derekfountain/zx-spectrum-coprocessor/test/logic_analyser_captures/dma_corruption/PXL_20250410_131411204.jpg

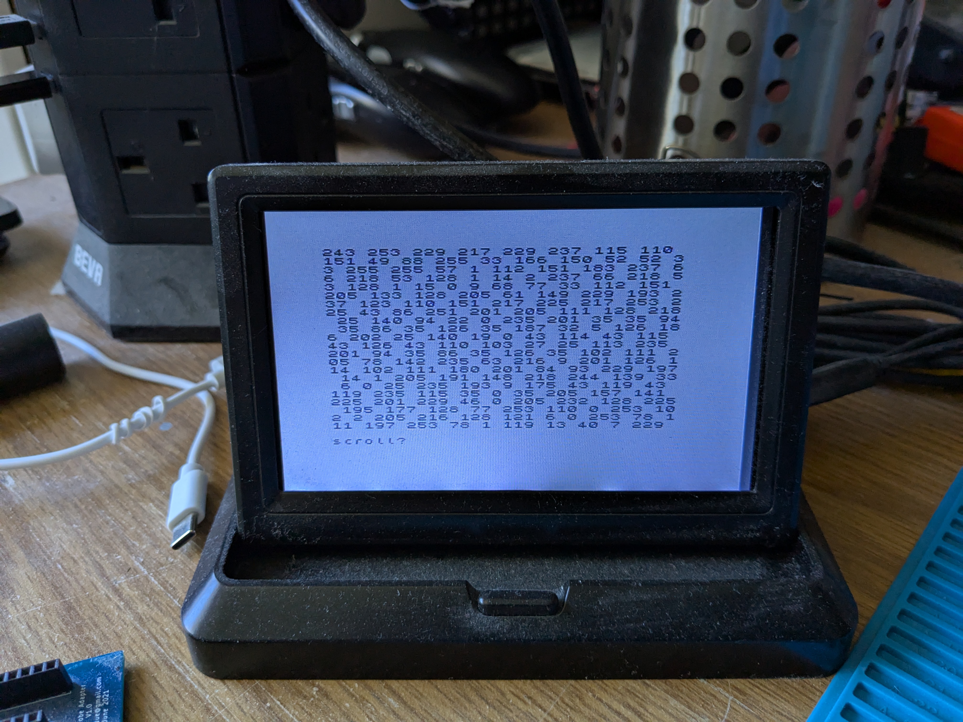
test/logic_analyser_captures/dma_corruption/PXL_20250410_131411204.jpg
