derekfountain/zx-spectrum-coprocessor/README.md

# zx-spectrum-coprocessor
Adding a modern microcontroller to a ZX Spectrum as a coprocessor
