derekfountain/zx-spectrum-coprocessor/test/spectrum/memset/contended_trace1.png

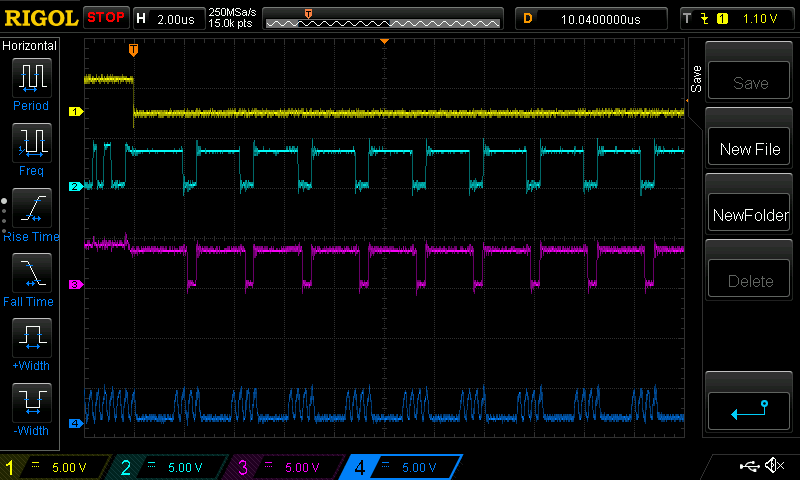
test/spectrum/memset/contended_trace1.png
