derekfountain/zx-spectrum-coprocessor/test/spectrum/memset/contended_trace2.png

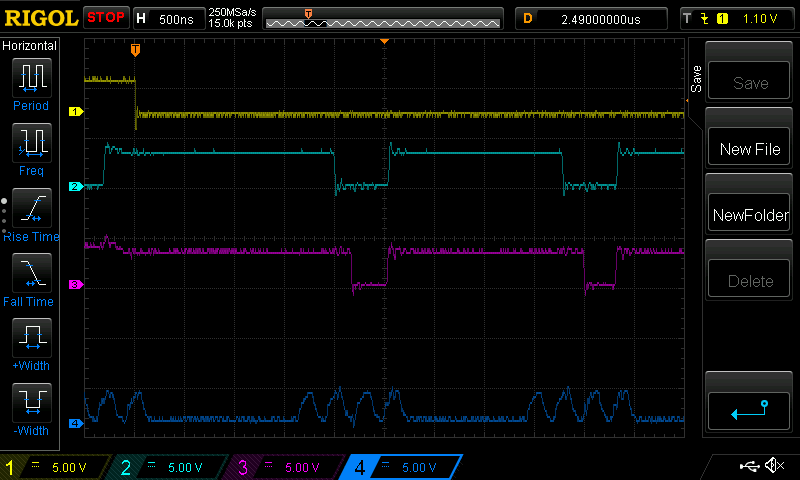
test/spectrum/memset/contended_trace2.png
