derekfountain/zx-spectrum-coprocessor/test/logic_analyser_captures/dma_corruption/LA_screenshot.png

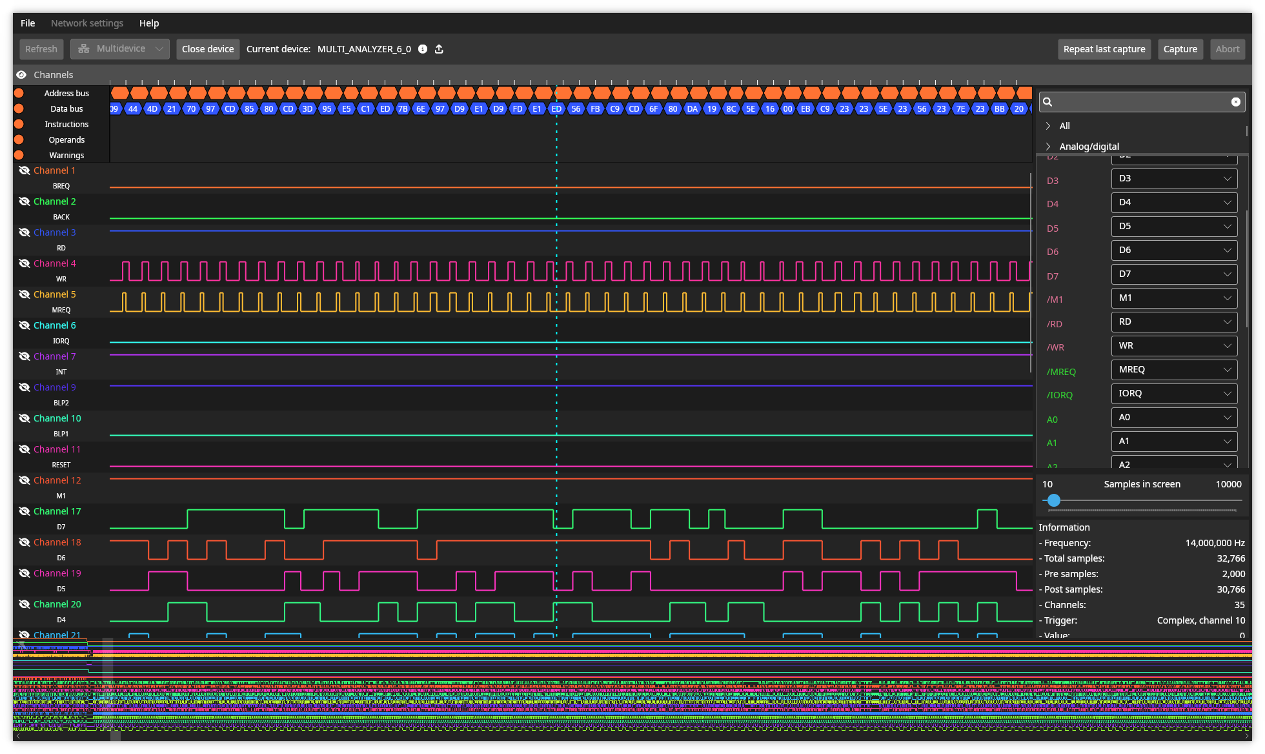
test/logic_analyser_captures/dma_corruption/LA_screenshot.png
