derekfountain/zx-spectrum-coprocessor/test/logic_analyser_captures/no_alarm_2byte_dma/no_glitch_2byte_dma_bit_instr.png

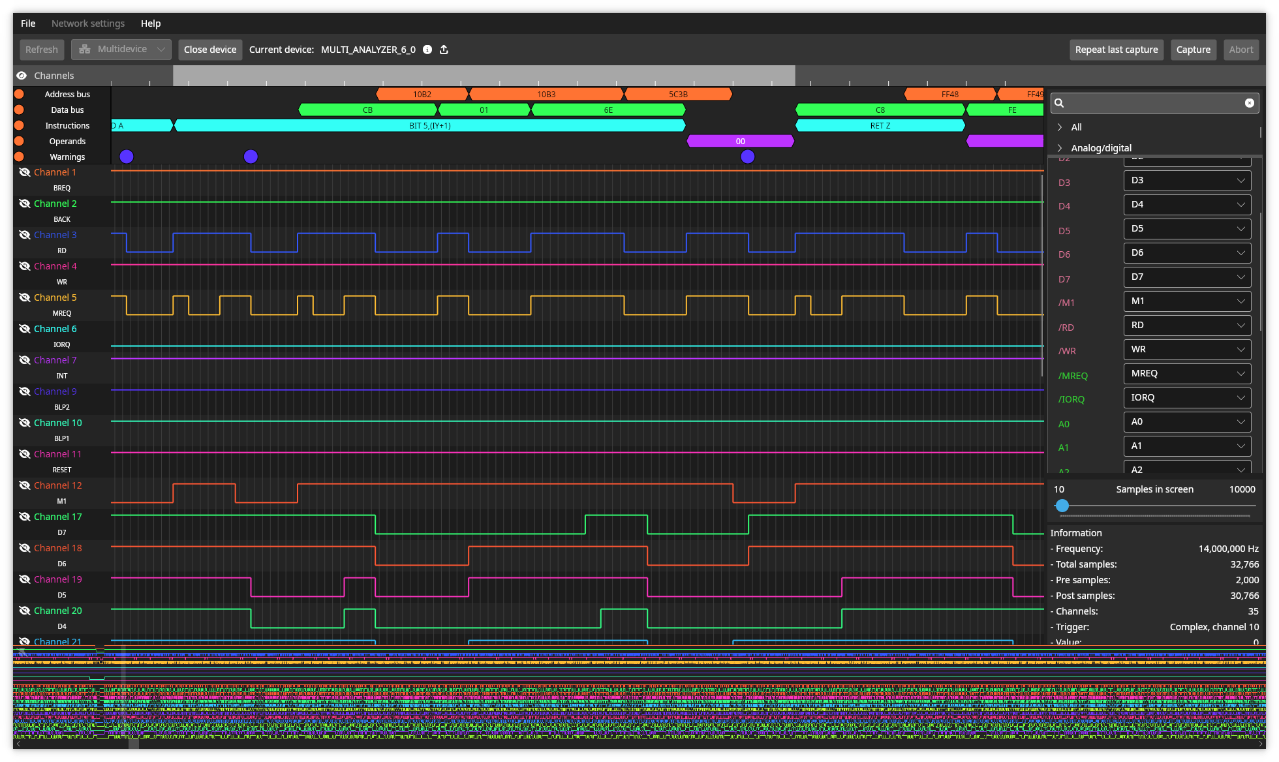
test/logic_analyser_captures/no_alarm_2byte_dma/no_glitch_2byte_dma_bit_instr.png
