derekfountain/zx-spectrum-coprocessor/test/logic_analyser_captures/zx_glitch_2byte_dma/zx_glitch_2byte_dma.png

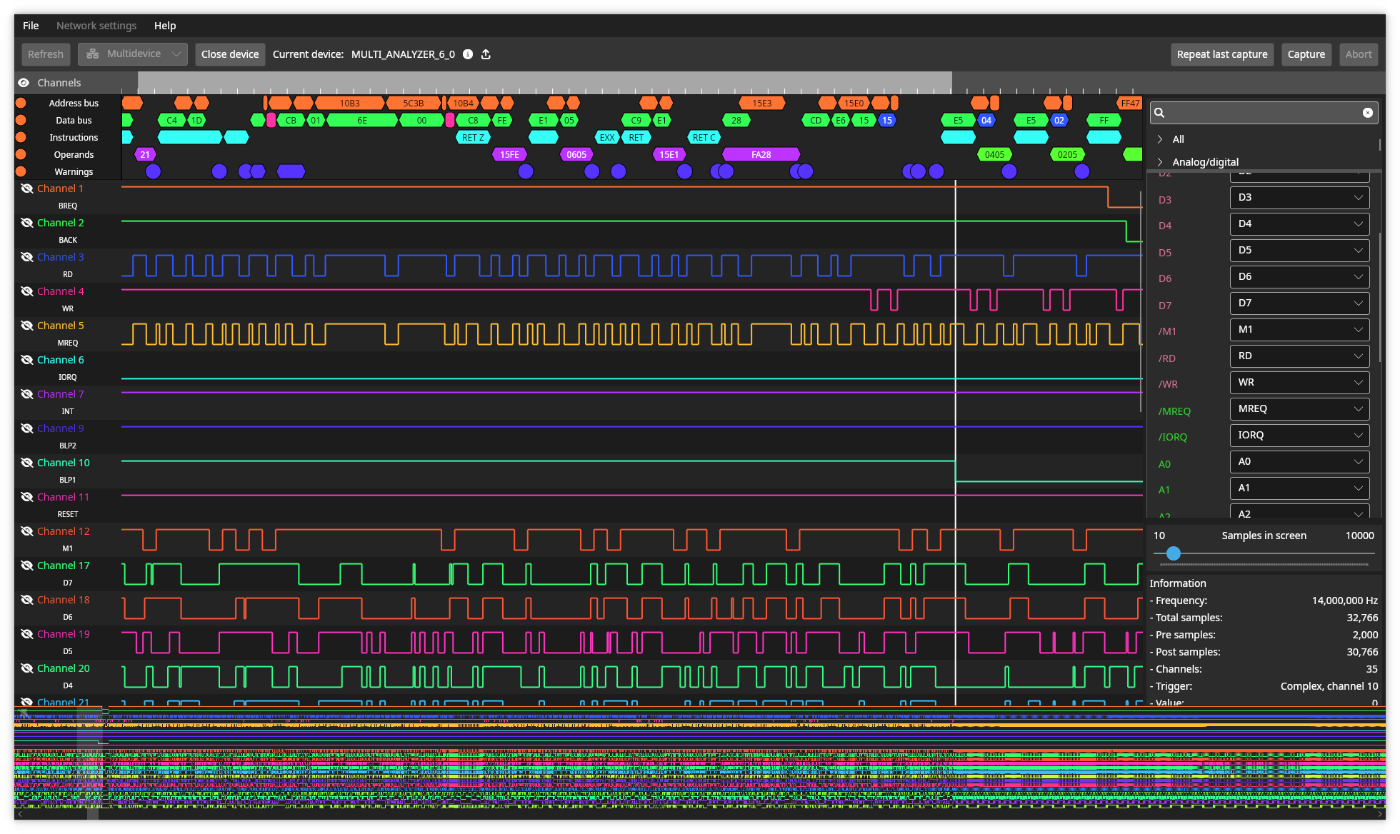
test/logic_analyser_captures/zx_glitch_2byte_dma/zx_glitch_2byte_dma.png
