derekfountain/zx-spectrum-coprocessor/test/logic_analyser_captures/zx_glitch_2byte_dma/zx_glitch_2byte_dma_bad_bit_instr.png

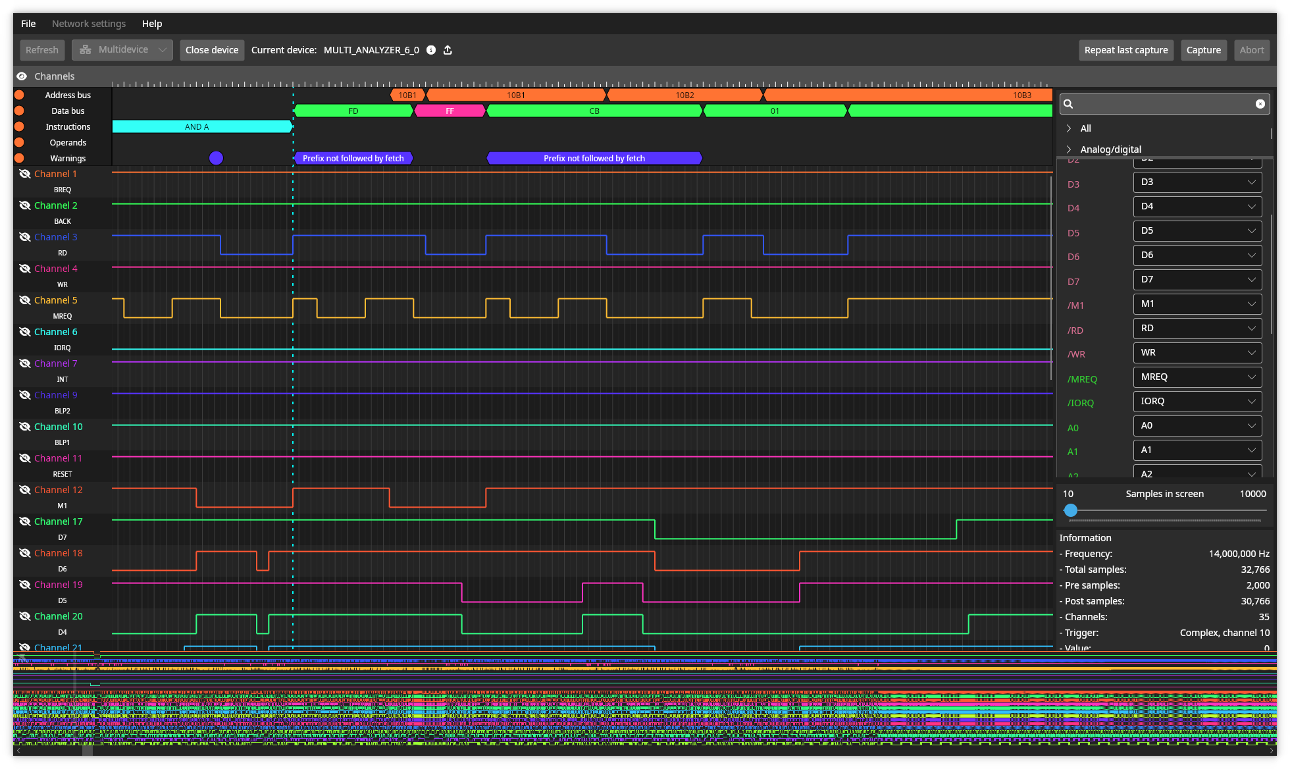
test/logic_analyser_captures/zx_glitch_2byte_dma/zx_glitch_2byte_dma_bad_bit_instr.png
