derekfountain/zx-spectrum-coprocessor/test/logic_analyser_captures/contended_failure/LA_failure_cap.png

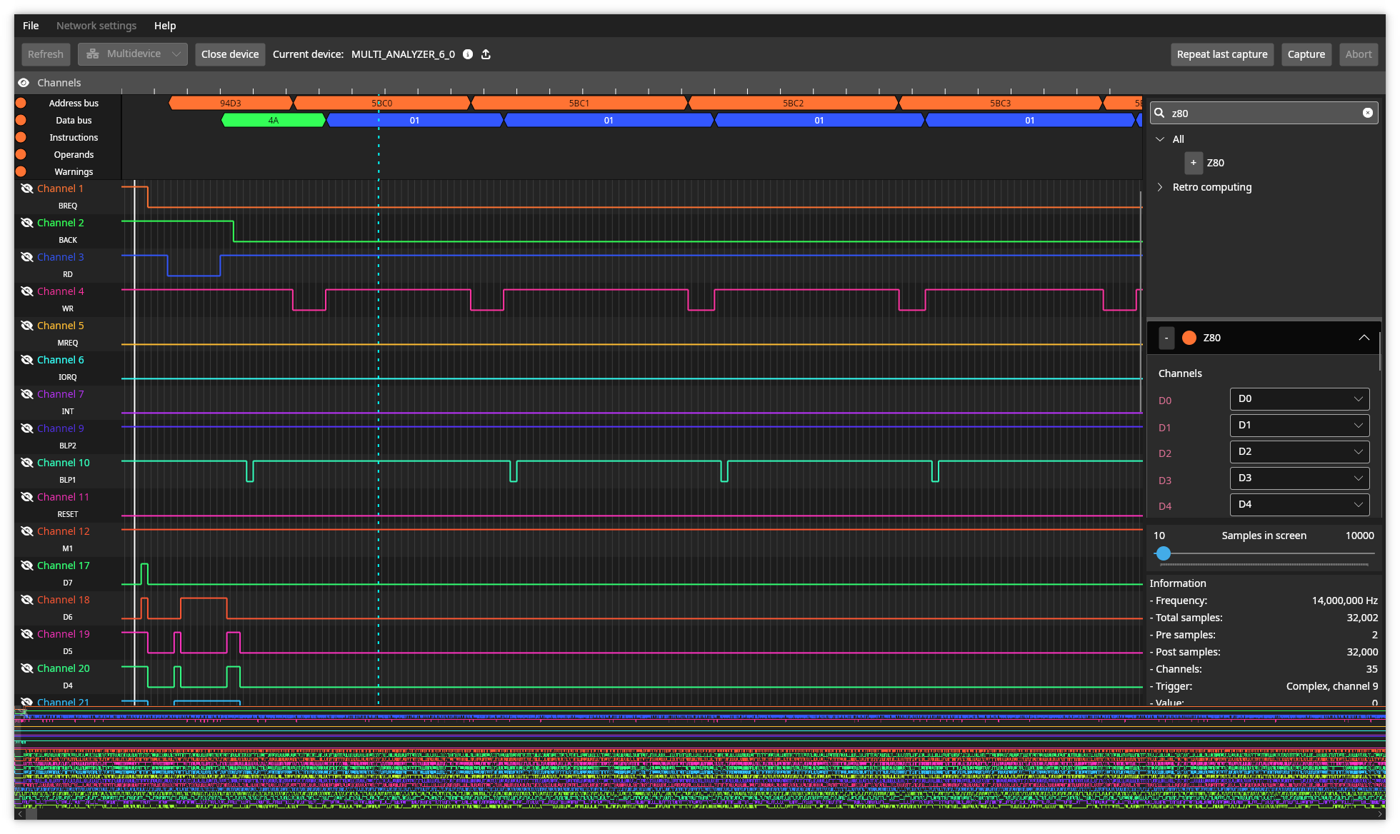
test/logic_analyser_captures/contended_failure/LA_failure_cap.png
