derekfountain/zx-spectrum-coprocessor/test/logic_analyser_captures/contended_failure/successful_1.png

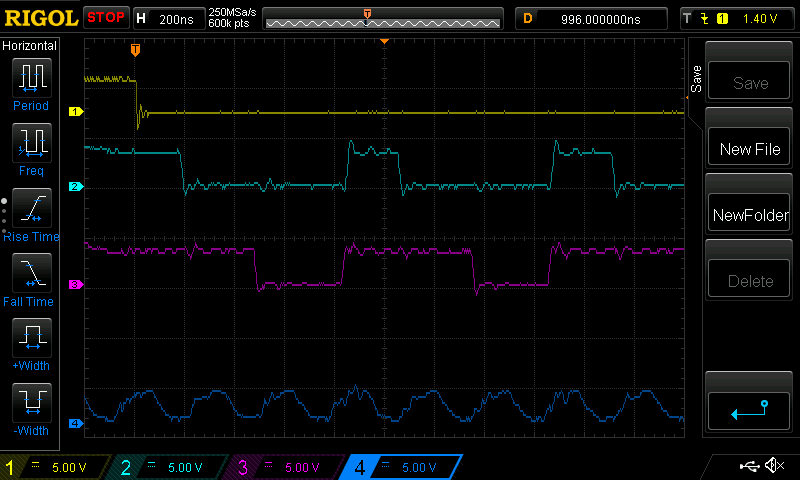
test/logic_analyser_captures/contended_failure/successful_1.png
