derekfountain/zx-spectrum-coprocessor/test/logic_analyser_captures/contended_failure/successful_2.png

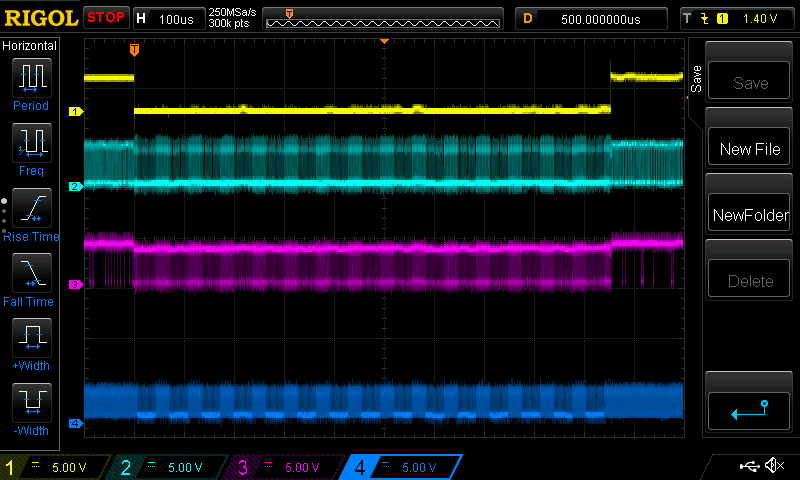
test/logic_analyser_captures/contended_failure/successful_2.png
