derekfountain/zx-spectrum-coprocessor/(list of files, drawings)

Other design files:
pcb/rp2xxx_stamp_footprints/Altium/RP2xxx_Stamp.SchLib
