derekfountain/zx-spectrum-coprocessor/firmware/dma_engine.c

/*
 * ZX Coprocessor Firmware, a Raspberry Pi RP2350b based Spectrum device
 * Copyright (C) 2025 Derek Fountain
 * 
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
 * You should have received a copy of the GNU General Public License
 * along with this program; if not, write to the Free Software
 * Foundation, Inc., 51 Franklin Street, Fifth Floor, Boston, MA  02110-1301, USA.
 */

#include "hardware/gpio.h"
#include "hardware/timer.h"

#include "zx_copro.h"
#include "dma_engine.h"

#include "gpios.h"
#include "zx_memory_management.h"
#include "zx_mirror.h"

#include "hardware/pio.h"
#include "hardware/dma.h"
#include "int_unsafe.pio.h"
#include "trace_table.h"

/* DMA queue */
typedef struct _DMA_QUEUE_ENTRY
{
  uint8_t  *src;
  ZX_ADDR   zx_ram_location;
  uint32_t  length;
}
DMA_QUEUE_ENTRY;

/* Not sure if this queue idea is going anywhere yet */
static DMA_QUEUE_ENTRY dma_queue[1] = {0};
void add_dma_to_queue( uint8_t *src, ZX_ADDR zx_ram_location, uint32_t length )
{
  dma_queue[0].src             = src;
  dma_queue[0].zx_ram_location = zx_ram_location;
  dma_queue[0].length          = length;
}

uint32_t is_dma_queue_full( void )
{
  return (dma_queue[0].src != NULL);
}

#include "z80_test_image.h"
void activate_dma_queue_entry( void )
{
  if( dma_queue[0].src != NULL )
  {
    DMA_BLOCK block = { dma_queue[0].src, dma_queue[0].zx_ram_location, dma_queue[0].length, 1 };

    trace_table_new_entry();
    trace_table_set_dma_args( block.src, block.zx_ram_location, block.length );

    dma_memory_block( &block, true );

    dma_queue[0].src = NULL;

    // FIXME This is wrong, test image shouldn't be exposed here
    if( 0 && using_z80_test_image() )
    {
      // This doesn't work, and can't work. see comments in rom_emulation.c
      /*
        * If we're using the Z80 test code and emulating the ROM, reset the Z80
        * and set the flag which causes the JP 0x8000 at the start of the
        * emulated ROM.
        * This isn't really correct, the memory blocked DMAed above might not be
        * the test code, it might be something else. This all needs working out.
        */
      set_initial_jp( 0x8000 );
    
      gpio_put( GPIO_RESET_Z80, 1 );
      busy_wait_us_32( 100 );
      gpio_put( GPIO_RESET_Z80, 0 );
    }
  }
}

/*
 * Flag set by a PIO routine which monitors the Spectrum's /INT line.
 * This is set true when it's unsafe to do a DMA into the Spectrum 
 * due to the risk of the Spectrum missing the next /INT
 */
static volatile uint32_t interrupt_unsafe = 0;

/*
 * I probably need to break this into 2 parts.
 * For DMAs into 0x4000-0x7FFF I need to work at the speed of the ULA. I need to work in top border
 * time so there's no contention and the ULA never stops the clock.
 * 
 * For DMAs into 0x8000-0xFFFF the ULA isn't involved and won't stop the clock. The RAS/CAS is done
 * by 74 logic chips on the Spectrum's main board, so I need to run at their maximum speed.
 * 
 * I also need to check the DMA requested doesn't run across the 0x7FFF-0x8000 boundary, and is
 * otherwise in sensible memory locations.
 */

DMA_STATUS dma_memory_block( const DMA_BLOCK *data_block,
                             const bool int_protection ) 
{
  if( data_block == NULL || data_block->src == NULL )
    return DMA_STATUS_BAD_STRUCT;

  if( data_block->length == 0 )
    return DMA_STATUS_TOO_SMALL;

  if( data_block->length > MAX_DMA_LENGTH )
    return DMA_STATUS_TOO_BIG;

  if( data_block->incr > MAX_INCR )
    return DMA_STATUS_BAD_INCR;

  /* The mode to use is worked out with heuristics */
  DMA_MODE mode;

  /*
   * If the start or end is in the contended memory, it's contended. I choose to check the
   * end as well on the basis that it's possible to do a large transfer across the ROM space.
   * i.e. start in upper RAM or ROM, end in screen memory, is technically possible
   */ 
  if( ((data_block->zx_ram_location >= 0x4000) && (data_block->zx_ram_location <= 0x7FFF))
      ||
      ((data_block->zx_ram_location+data_block->length >= 0x4000) && (data_block->zx_ram_location+data_block->length <= 0x7FFF)) )
  {
    /* Contended memory, but if it's confirmed as running in top border time that's OK as long as it's small */
    if( data_block->top_border_time == true )
    {
      /*
       * In top border time, bail out if it's too big. (The transfer would take too long and
       * the screen will glitch.)
       */
      if( data_block->length > TOP_BORDER_MAX_LENGTH )
      {
        return DMA_STATUS_TOP_BORDER_TOO_BIG;
      }
      else
      {
        /*
         * DMA into contended memory, but it's only small and we've been told it's
         * happening in top border time, so no contention will happen.
         */
        mode = DMA_MODE_TOP_BORDER;
      }
    }
    else
    {
      /* If contended location, and we're not running the transfer in top border time, Z80 write timings are essential */
      mode = DMA_MODE_CONTENDED;
    }
  }
  else
  {
    /* Upper RAM (or possibly ROM), there is no contention so it's simple */
    mode = DMA_MODE_UNCONTENDED;
  }

  trace_table_set_dma_mode( mode );

  /*
   * The Spectrum can't afford to miss an interrupt, so if one is approaching,
   * and the Z80 cares, spin while it passes
   */
  if( !data_block->ignore_interrupt && int_protection )
  {
    /*
     * A combination of the int_unsafe PIO program and
     * RP2350 DMA keep this global variable updated
     */
    while( interrupt_unsafe )
    {
      gpio_put( GPIO_BLIPPER2, 1 );
      gpio_put( GPIO_BLIPPER2, 0 );
    };
  }

  /*
   * Empirical testing shows the DMA initialiation setup takes at most 8.5us.
   * That's with a 200MHz overclock, but I'm not sure that makes much difference
   */

  /* Assert bus request */
  gpio_put( GPIO_Z80_BUSREQ, 0 );

  /*
   * Spin waiting for Z80 to acknowledge. BUSACK goes active (low) on the 
   * rising edge of the clock - see fig8 in the Z80 manual
   */
  while( gpio_get( GPIO_Z80_BUSACK ) == 1 );

  /* OK, we have the Z80's bus */

  /* RD and IORQ lines are unused by this DMA process and stay inactive */
  gpio_set_dir( GPIO_Z80_RD,   GPIO_OUT ); gpio_put( GPIO_Z80_RD,   1 );
  gpio_set_dir( GPIO_Z80_IORQ, GPIO_OUT ); gpio_put( GPIO_Z80_IORQ, 1 );

  /* Reset Z80 address and data bus GPIOs as outputs */
  gpio_set_dir_out_masked( GPIO_ABUS_BITMASK );
  gpio_set_dir_out_masked( GPIO_DBUS_BITMASK );

  /* Set directions of control signals to outputs */
  gpio_set_dir( GPIO_Z80_MREQ, GPIO_OUT ); gpio_put( GPIO_Z80_MREQ, 1 );
  gpio_set_dir( GPIO_Z80_WR,   GPIO_OUT ); gpio_put( GPIO_Z80_WR,   1 );

  if( mode == DMA_MODE_CONTENDED )
  {
    /* Blipper goes low while DMA process is active */
    //gpio_put( GPIO_BLIPPER1, 0 );

    /*
     * We're DMAing into contended memory. In theory, as long as this code matches
     * exactly what the Z80 does, and so stops when the ULA stops the Z80's clock,
     * it will match the Z80's contended behaviour and the contention won't disturb
     * anything.
     * 
     * This approach is the slowest option, waiting for each clock edge in the same
     * way the Z80 does.
     *
     * So, this matches the Z80's timings on the bus. It syncs to the clock signal. As far as
     * I can tell, the ULA can't tell the difference between the RP2350 running this code
     * and the Z80 it normally writes memory for.
     * 
     * The contents of this loop takes 800ns per iteration, plus another 50ns for the loop.
     * At 3.5MHz the 3-cycle write should take 857ns, so that looks right.
     * 
     * The problem here is that it's slow. A 6,912 byte screen contents DMA takes 5.92ms
     * which is way slower than I'd like and nowhere near fast enough for top border time.
     */

    /* Wait for rising edge of clock, syncs to start of T1 (Z80 manual fig 6, right side) */
    while( gpio_get( GPIO_Z80_CLK ) == 0 );  
    
    uint32_t offset = 0;
    for( uint32_t byte_counter=0; byte_counter < data_block->length; byte_counter++ )
    {
      /* Set address of ZX byte to write to */
      gpio_put_masked( GPIO_ABUS_BITMASK, (data_block->zx_ram_location+byte_counter)<<GPIO_ABUS_A0 );

      /*
       * If the ULA is going to call contention when it sees this address, it will do it inside 
       * half a Z80 clock cycle - that's 143ns. So pause for half a clock. This takes us to
       * just past halfway through T1, CLK will now be low either because things are progressing
       * as normal, or because the ULA has pulled the CLK low to stop it..
       */
      {
      __asm volatile ("nop");
      __asm volatile ("nop");
      __asm volatile ("nop");
      __asm volatile ("nop");
      __asm volatile ("nop");

      __asm volatile ("nop");
      __asm volatile ("nop");
      __asm volatile ("nop");
      __asm volatile ("nop");
      __asm volatile ("nop");

      __asm volatile ("nop");
      __asm volatile ("nop");
      __asm volatile ("nop");
      __asm volatile ("nop");
      __asm volatile ("nop");

      __asm volatile ("nop");
      __asm volatile ("nop");
      __asm volatile ("nop");
      __asm volatile ("nop");
      __asm volatile ("nop");

      __asm volatile ("nop");
      __asm volatile ("nop");
      __asm volatile ("nop");
      __asm volatile ("nop");
      __asm volatile ("nop");

      __asm volatile ("nop");
      __asm volatile ("nop");
      __asm volatile ("nop");
      __asm volatile ("nop");
      }

      /*
       * The clock is now low. If it's low because things are progressing normally it's time to
       * put MREQ and the data on the buses; but if the clock is low because the ULA is holding
       * it, I need to wait until the ULA is done. As far as I can tell, there's no way I can
       * differentiate these situtation, so I have to wait for the clock to cycle high again.
       * That guarantees the clock isn't low because the ULA is holding it.
       */
      while( gpio_get( GPIO_Z80_CLK ) == 0 );

      /*
       * The clock is now high again, either because a wasted cycle has passed, or the ULA has
       * released it from contention. Either way, when I detect the falling edge it's time
       * to continue the DMA byte transfer. We're at the falling edge halfway through T1.
       */
      while( gpio_get( GPIO_Z80_CLK ) == 1 );  

      /* Assert memory request */
      gpio_put( GPIO_Z80_MREQ, 0 );

      /* Put value on the data bus */
      gpio_put_masked( GPIO_DBUS_BITMASK, *(data_block->src+offset) );
      offset += data_block->incr;

      /*
      * Wait for Z80 clock to rise and fall - that's at the clock low point halfway through T2
      */
      while( gpio_get( GPIO_Z80_CLK ) == 0 );    
      while( gpio_get( GPIO_Z80_CLK ) == 1 );   

      /*
      * Assert the write line to write it, the ULA responds to this and does
      * the write into the Spectrum's memory. i.e. the RAS/CAS stuff.
      */
      gpio_put( GPIO_Z80_WR, 0 );

      /*
      * Wait for Z80 clock to rise and fall again - that takes us
      * to the beginning of, and then the halfway point of, T3
      */
      while( gpio_get( GPIO_Z80_CLK ) == 0 );    
      while( gpio_get( GPIO_Z80_CLK ) == 1 );   

      /* Update local mirror to match the ZX RAM */
      put_zx_mirror_byte( data_block->zx_ram_location+byte_counter, *(data_block->src+byte_counter) );

      /* Remove write and memory request */
      gpio_put( GPIO_Z80_WR,   1 );
      gpio_put( GPIO_Z80_MREQ, 1 ); 

      /* Wait for the next rising edge of the clock - that's the end of T3 / start of T1 */
      while( gpio_get( GPIO_Z80_CLK ) == 0 );    
    }
  }
  else if( mode == DMA_MODE_TOP_BORDER )
  {
    /* Blipper goes low while DMA process is active */
    //gpio_put( GPIO_BLIPPER1, 0 );

    /*
     * DMA into lower, contended memory, ignoring contention. This can only be used
     * when the Z80 program passes in flags saying it's in top border time. It is,
     * therefore, the Z80 program's responsibility to ensure this only runs when
     * it's safe to do so.
     * 
     * This is the fastest option, running at ULA-speed without worrying about Z80
     * sync or what the RAS/CAS generation logic ICs are doing. It uses timings
     * based on a sequence of NOPs, like the uncontended mode, but it drives the
     * ULA into making the RAS/CAS signals, not the standalone logic ICs. The ULA
     * appears to run faster than those ICS.
     */

    uint32_t offset = 0;
    for( uint32_t byte_counter=0; byte_counter < data_block->length; byte_counter++ )
    {
      /* Set address of ZX byte to write to */
      gpio_put_masked( GPIO_ABUS_BITMASK, (data_block->zx_ram_location+byte_counter)<<GPIO_ABUS_A0 );

      /* Assert memory request */
      gpio_put( GPIO_Z80_MREQ, 0 );

      /* Put value on the data bus */
      gpio_put_masked( GPIO_DBUS_BITMASK, *(data_block->src+offset) );
      offset += data_block->incr;

      /*
       * Assert the write line to write it, the ULA responds to this and does
       * the write into the Spectrum's memory. i.e. the RAS/CAS stuff.
       */
      gpio_put( GPIO_Z80_WR, 0 );

      /*
       * The timing theory:
       * Spectrum RAM is rated 150ns which is 1.5e-07. RP2350 clock speed is
       * 200,000,000Hz (overclocked), so one clock cycle is 5ns. So that's 30
       * RP2350 clock cycles in one DRAM transaction time. However, I'm not
       * driving the chips, the ULA generates the RAS/CAS signals.
       * 
       * I don't know the characteristics of the logic devices inside the ULA.
       * Emprical testing is all I can do, and that suggests that it's faster
       * than the SN74LSxx logic that drives the upper RAM.
       * 
       * I need to support both the original 4116s and the modern static RAM
       * memory module boards. It turns out the 4116s are slower.
       * 
       * Empirical testing shows it needs 37 RP2350 cycles.
       */
      {
        __asm volatile ("nop");
        __asm volatile ("nop");
        __asm volatile ("nop");
        __asm volatile ("nop");
        __asm volatile ("nop");

        __asm volatile ("nop");
        __asm volatile ("nop");
        __asm volatile ("nop");
        __asm volatile ("nop");
        __asm volatile ("nop");

        __asm volatile ("nop");
        __asm volatile ("nop");
        __asm volatile ("nop");
        __asm volatile ("nop");
        __asm volatile ("nop");

        __asm volatile ("nop");
        __asm volatile ("nop");
        __asm volatile ("nop");
        __asm volatile ("nop");
        __asm volatile ("nop");

        __asm volatile ("nop");
        __asm volatile ("nop");
        __asm volatile ("nop");
        __asm volatile ("nop");
        __asm volatile ("nop");

        __asm volatile ("nop");
        __asm volatile ("nop");
        __asm volatile ("nop");
        __asm volatile ("nop");
        __asm volatile ("nop");

        __asm volatile ("nop");
        __asm volatile ("nop");
        __asm volatile ("nop");
        __asm volatile ("nop");
        __asm volatile ("nop");

        __asm volatile ("nop");
        __asm volatile ("nop");
      }
      /* Mirror and buses reset takes ~100ns */

      /* Update local mirror to match the ZX RAM */
      put_zx_mirror_byte( data_block->zx_ram_location+byte_counter, *(data_block->src+byte_counter) );

      /* Remove write and memory request */
      gpio_put( GPIO_Z80_WR,   1 );
      gpio_put( GPIO_Z80_MREQ, 1 ); 
    }
  }
  else if( mode == DMA_MODE_UNCONTENDED )
  {
    /*
     * DMA into upper memory. This 4164 based DRAM is driven by RAS/CAS signals generated by
     * logic chips (as opposed to the ULA which does that job for the lower RAM). This code
     * needs to run with timings based on what those ICs can manage. I could stick with the
     * Z80 timings, since those are guaranteed to work, but I can drive this faster.
     */

    /* Blipper goes low while DMA process is active */
    //gpio_put( GPIO_BLIPPER1, 0 );

    uint32_t offset = 0;
    for( uint32_t byte_counter=0; byte_counter < data_block->length; byte_counter++ )
    {
      /*
       * Wait for rising edge of clock, syncs to start of T1 (Z80 manual fig 6, right side).
       * This isn't syncing to the Z80 in any way, it's just using the CLK to pace itself
       * so the DRAMs are happy with the timings 
       */
      while( gpio_get( GPIO_Z80_CLK ) == 0 ); 

      /* Set up of buses takes ~150ns */

      /* Set address of ZX byte to write to */
      gpio_put_masked( GPIO_ABUS_BITMASK, (data_block->zx_ram_location+byte_counter)<<GPIO_ABUS_A0 );

      /*
       * Wait for falling edge of clock, halfway through T1, this step appears necessary
       * to pace the DRAMs, otherwise the DMA is unreliable
       */
      while( gpio_get( GPIO_Z80_CLK ) == 1 ); 

      /* Assert memory request */
      gpio_put( GPIO_Z80_MREQ, 0 );

      /* Put value on the data bus */
      gpio_put_masked( GPIO_DBUS_BITMASK, *(data_block->src+offset) );
      offset += data_block->incr;

      /*
      * Assert the write line to write it, the logic responds to this and does
      * the write into the Spectrum's memory. i.e. the RAS/CAS stuff.
      */
      gpio_put( GPIO_Z80_WR, 0 );

      /*
      * The timing theory:
      * Spectrum RAM is rated 150ns which is 1.5e-07. RP2350 clock speed is
      * 200,000,000Hz (overclocked), so one clock cycle is 5ns. So that's 30
      * RP2350 clock cycles in one DRAM transaction time. However, I'm not
      * driving the chips, the logic generates the RAS/CAS signals that do
      * that.
      * 
      * SN74LS32 logic switches at max 22ns, and there's 3 such gates. Plus
      * SN74LS00 logic which switches at 15ns, and there's 2. All in series
      * so 22+22+22+15+15=96ns, plus another 27ns for the 74LS157s to switch
      * (simultaneously), so 123ns in absolute worst case for the RAS/CAS
      * signals to be generated and applied to the 4164s.
      * 
      * If I read the datasheet correctly, there then needs to be a data hold
      * time of 45ns (th(CLD)), but that's concurrent with the 150ns it takes 
      * for the 4164 to do the write, so the hold time can be ignored as long
      * as I don't whip the data away too quickly.
      * 
      * So the worst case timing appears to be 123ns + 150ns which is 273ns.
      * 
      * But how much is really needed? 273s is absolute worst case for all the
      * chips in the sequence, and there's a bit of time after these NOPs while
      * the local mirror is updated and the WR and MREQ lines are pulled inactive. 
      * Emprical testing shows it's (apparently) 100% reliable with 250ns worth
      * of NOPs at this point, but I'm inclined to go with the theory.
      * 
      * That's the call then, at 200MHz 55 NOPs is 275ns, so 55 NOPs here.
      * 
      * I would admit this is a bit hand wavy... :)
      * 
      * At 200MHz this takes about 3.65ms to DMA around 8KB with 55 NOPs.
      */
     {
      __asm volatile ("nop");
      __asm volatile ("nop");
      __asm volatile ("nop");
      __asm volatile ("nop");
      __asm volatile ("nop");

      __asm volatile ("nop");
      __asm volatile ("nop");
      __asm volatile ("nop");
      __asm volatile ("nop");
      __asm volatile ("nop");

      __asm volatile ("nop");
      __asm volatile ("nop");
      __asm volatile ("nop");
      __asm volatile ("nop");
      __asm volatile ("nop");

      __asm volatile ("nop");
      __asm volatile ("nop");
      __asm volatile ("nop");
      __asm volatile ("nop");
      __asm volatile ("nop");

      __asm volatile ("nop");
      __asm volatile ("nop");
      __asm volatile ("nop");
      __asm volatile ("nop");
      __asm volatile ("nop");

      __asm volatile ("nop");
      __asm volatile ("nop");
      __asm volatile ("nop");
      __asm volatile ("nop");
      __asm volatile ("nop");

      __asm volatile ("nop");
      __asm volatile ("nop");
      __asm volatile ("nop");
      __asm volatile ("nop");
      __asm volatile ("nop");

      __asm volatile ("nop");
      __asm volatile ("nop");
      __asm volatile ("nop");
      __asm volatile ("nop");
      __asm volatile ("nop");

      __asm volatile ("nop");
      __asm volatile ("nop");
      __asm volatile ("nop");
      __asm volatile ("nop");
      __asm volatile ("nop");

      __asm volatile ("nop");
      __asm volatile ("nop");
      __asm volatile ("nop");
      __asm volatile ("nop");
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
      __asm volatile ("nop");
      __asm volatile ("nop");
      __asm volatile ("nop");
      __asm volatile ("nop");
      __asm volatile ("nop");
      __asm volatile ("nop");
      __asm volatile ("nop");
      __asm volatile ("nop");
      __asm volatile ("nop");
      __asm volatile ("nop");
      __asm volatile ("nop");
      __asm volatile ("nop");
      __asm volatile ("nop");
      __asm volatile ("nop");
#endif      
      }

      /* Mirror and buses reset takes ~100ns */

      /* Update local mirror to match the ZX RAM */
      put_zx_mirror_byte( data_block->zx_ram_location+byte_counter, *(data_block->src+byte_counter) );

      /* Remove write and memory request */
      gpio_put( GPIO_Z80_WR,   1 );
      gpio_put( GPIO_Z80_MREQ, 1 ); 
    }

  }
  else
  {
    /* Can't happen */
    return DMA_STATUS_CONTENTION_FAIL;
  }

  /*
   * Empirical testing shows this DMA teardown takes at most 1.6us.
   */

  /* DMA complete - put the address, data and control buses back to hi-Z */
  gpio_set_dir_in_masked( GPIO_ABUS_BITMASK );
  gpio_set_dir_in_masked( GPIO_DBUS_BITMASK );

  gpio_set_dir( GPIO_Z80_MREQ, GPIO_IN );
  gpio_set_dir( GPIO_Z80_WR,   GPIO_IN );
  gpio_set_dir( GPIO_Z80_IORQ, GPIO_IN );
  gpio_set_dir( GPIO_Z80_RD,   GPIO_IN );

  /* Release bus request */
  gpio_put( GPIO_Z80_BUSREQ, 1 );

  /* Wait for ack to go inactive again */
  while( gpio_get( GPIO_Z80_BUSACK ) == 0 );

  /* Indicate DMA process complete, inactive */
  gpio_put( GPIO_BLIPPER1, 1 );

  return DMA_STATUS_OK;
}

void init_interrupt_protection( void )
{
  /*
   * Use PIO to time DMA missing the /INT signal. The INT signal is in the lower range
   * of GPIOs, but a test signal will need to be in the upper range. So set the base
   * to 16.
   */
  PIO pio                = pio0;
  pio_set_gpio_base( pio, 16 );
  uint sm_int_unsafe     = pio_claim_unused_sm( pio, true );
  uint offset_int_unsafe = pio_add_program( pio, &int_unsafe_program );
  int_unsafe_program_init( pio, sm_int_unsafe, offset_int_unsafe, GPIO_Z80_INT, GPIO_INT_UNSAFE );
  pio_sm_set_enabled( pio, sm_int_unsafe, false);

  /*
   * Set up the DMA channel which transfers a flag value from the PIO which indicates
   * it's unsafe for a Z80 DMA to proceed due to the risk of the Z80 missing the next
   * interrupt. The value is a 0 if there's no risk, and 1 if there is risk. It arrives
   * in the RX FIFO, this DMA moves it into a local variable.
   * I'm not sure this is strictly necessary, I think I could just access the flag as the
   * FIFO entry directly with pio0_hw->rxf[0]. But this seems the right way to do it.
   * The DREQ (data request) is set to make the DMA respond when the PIO
   * makes a value available on the RX FIFO.
   */
  int int_unsafe_dma_channel               = dma_claim_unused_channel( true );
  dma_channel_config int_unsafe_dma_config = dma_channel_get_default_config( int_unsafe_dma_channel );
  channel_config_set_transfer_data_size( &int_unsafe_dma_config, DMA_SIZE_32 );
  channel_config_set_read_increment( &int_unsafe_dma_config, false );
  channel_config_set_dreq( &int_unsafe_dma_config, DREQ_PIO0_RX0 );

  dma_channel_configure( int_unsafe_dma_channel,
                         &int_unsafe_dma_config,
                         &interrupt_unsafe,            // Write address, the local variable
                         &pio0_hw->rxf[0],             // Read address, the FIFO register
                         0xFFFFFFFF,                   // 0x0FFFFFFF plus 0xF0000000, ENDLESS, Spec 12.6.2.2.1
                         true                          // Start immediately
                       );

  /*
   * Set up the DMA channel which provides the countdown value for the PIO which handles
   * the "interrupt unsafe" timer. This DMA just sends the same 32 bit value to the PIO
   * each time the PIO asks for it.
   */
  int int_interval_dma_channel               = dma_claim_unused_channel( true );
  dma_channel_config int_interval_dma_config = dma_channel_get_default_config( int_interval_dma_channel );
  channel_config_set_transfer_data_size( &int_interval_dma_config, DMA_SIZE_32 );
  channel_config_set_write_increment( &int_interval_dma_config, false );
  channel_config_set_read_increment( &int_interval_dma_config, false );
  channel_config_set_dreq( &int_interval_dma_config, DREQ_PIO0_TX0 );

  /*
   * Interval countdown. The ULA generates /INTs at 19.97ms intervals (close to 20ms
   * but not quite). That's 19,970,000ns, at 5ns per cycle (200MHz) that's 3,994,000
   * cycles from /INT to /INT. I want a 30us pause to come in just before the /INT.
   * That's 30,000ns, or 6,000 cycles. So I want the countdown to run from /INT to 6,000
   * cycles before the next /INT, which is 3,994,000-6,000. But that gives a pre-INT
   * pause of about 38us, not 30us. I don't know why.
   * I discovered empirically that a countdown of 3,994,000-4,000 gives a pre-INT pause
   * of about 29us, which will do the job. My best guess is that the 19.97ms time between
   * INTs, which came from Smith's ULA book is not quite as precise as I'm assuming it
   * is. Or maybe the crystal in the 40 year old Spectrum I'm testing with has wandered
   * a bit. I could reimplement with some sort of dynamic measuring, but I think this
   * is good enough.
   */  
  static const uint32_t interval_countdown = 3994000-4000;
  dma_channel_configure( int_interval_dma_channel,
                         &int_interval_dma_config,
                         &pio0_hw->txf[0],             // Write address, PIO's FIFO
                         &interval_countdown,          // Read address, value to send
                         0xF0000001,                   // 1 transfer, plus 0xF0000000, ENDLESS, Spec 12.6.2.2.1
                         true                          // Start immediately
                        );

  /* Start the PIO running */
  pio_sm_set_enabled( pio, sm_int_unsafe, true);

  return;
}

void init_dma_engine( void )
{
  dma_queue[0].src = NULL;
  return;
}
