derekfountain/zx-spectrum-coprocessor/firmware/z80_image.h

unsigned char z80_image_CODE_bin[] = {
  0xf3, 0xfd, 0xe5, 0xd9, 0xe5, 0xed, 0x73, 0xf8, 0x9b, 0x31, 0x58, 0xff, 0x21, 0x22, 0x9b, 0x34,
  0x34, 0x21, 0xff, 0xff, 0x39, 0x01, 0xfa, 0x9b, 0xb7, 0xed, 0x42, 0xda, 0x65, 0x80, 0x01, 0x0e,
  0x02, 0xed, 0x42, 0xda, 0x65, 0x80, 0x01, 0x0f, 0x00, 0x09, 0x44, 0x4d, 0x21, 0xfa, 0x9b, 0xcd,
  0xb5, 0x80, 0x21, 0xee, 0x9b, 0x36, 0x80, 0x23, 0x36, 0x00, 0x21, 0xf0, 0x9b, 0x36, 0x00, 0x21,
  0xf1, 0x9b, 0x36, 0x00, 0x21, 0xf2, 0x9b, 0x36, 0x00, 0x21, 0xf3, 0x9b, 0x36, 0x00, 0x21, 0xf4,
  0x9b, 0x36, 0x00, 0x21, 0xf5, 0x9b, 0x36, 0x00, 0x21, 0xf6, 0x9b, 0x36, 0x00, 0x21, 0xf7, 0x9b,
  0x36, 0x00, 0xcd, 0xdd, 0x95, 0xe5, 0xc1, 0xed, 0x7b, 0xf8, 0x9b, 0xd9, 0xe1, 0xd9, 0xfd, 0xe1,
  0xed, 0x56, 0xfb, 0xc9, 0xcd, 0x9f, 0x80, 0xda, 0x6b, 0x8c, 0x5e, 0x16, 0x00, 0xeb, 0xc9, 0x23,
  0x23, 0x5e, 0x23, 0x56, 0x23, 0x7e, 0x23, 0xbb, 0x20, 0x05, 0x7e, 0xba, 0xca, 0x6b, 0x8c, 0x13,
  0x2b, 0x2b, 0x72, 0x2b, 0x73, 0x2b, 0x7e, 0x2b, 0x6e, 0x67, 0x1b, 0x19, 0x71, 0xeb, 0xc9, 0x5e,
  0x23, 0x56, 0x23, 0x7e, 0x23, 0x66, 0x6f, 0xcd, 0xa0, 0x8e, 0xeb, 0x3f, 0xd8, 0x09, 0xc9, 0x7e,
  0x23, 0x66, 0x6f, 0xb4, 0xc9, 0x54, 0x5d, 0xe5, 0xc5, 0x0e, 0x01, 0xcd, 0x5f, 0x95, 0xda, 0x46,
  0x8c, 0x21, 0x06, 0x00, 0x19, 0xeb, 0xc1, 0x09, 0xaf, 0x2b, 0x77, 0x2b, 0x77, 0xeb, 0x73, 0x23,
  0x72, 0x23, 0xcd, 0xef, 0x8d, 0xe1, 0xc9, 0x7d, 0xe6, 0x07, 0x6f, 0x3a, 0xa3, 0x9a, 0xe6, 0xf8,
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
  0xc9, 0xfd, 0x7e, 0x06, 0xe6, 0xfc, 0xfd, 0x77, 0x06, 0xc9, 0x4d, 0x44, 0x11, 0xff, 0xff, 0x13,
  0xc5, 0xd5, 0x3e, 0x03, 0xcd, 0xd5, 0x8d, 0xd1, 0xc1, 0x38, 0x0e, 0x78, 0xb1, 0x28, 0x0a, 0x0b,
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
};
unsigned int z80_image_CODE_bin_len = 7162;
