derekfountain/zx-spectrum-coprocessor/firmware/rom.h

unsigned char _48_original_rom[] = {
  0xf3, 0xaf, 0x11, 0xff, 0xff, 0xc3, 0xcb, 0x11, 0x2a, 0x5d, 0x5c, 0x22,
  0x5f, 0x5c, 0x18, 0x43, 0xc3, 0xf2, 0x15, 0xff, 0xff, 0xff, 0xff, 0xff,
  0x2a, 0x5d, 0x5c, 0x7e, 0xcd, 0x7d, 0x00, 0xd0, 0xcd, 0x74, 0x00, 0x18,
  0xf7, 0xff, 0xff, 0xff, 0xc3, 0x5b, 0x33, 0xff, 0xff, 0xff, 0xff, 0xff,
  0xc5, 0x2a, 0x61, 0x5c, 0xe5, 0xc3, 0x9e, 0x16, 0xf5, 0xe5, 0x2a, 0x78,
  0x5c, 0x23, 0x22, 0x78, 0x5c, 0x7c, 0xb5, 0x20, 0x03, 0xfd, 0x34, 0x40,
  0xc5, 0xd5, 0xcd, 0xbf, 0x02, 0xd1, 0xc1, 0xe1, 0xf1, 0xfb, 0xc9, 0xe1,
  0x6e, 0xfd, 0x75, 0x00, 0xed, 0x7b, 0x3d, 0x5c, 0xc3, 0xc5, 0x16, 0xff,
  0xff, 0xff, 0xff, 0xff, 0xff, 0xff, 0xf5, 0xe5, 0x2a, 0xb0, 0x5c, 0x7c,
  0xb5, 0x20, 0x01, 0xe9, 0xe1, 0xf1, 0xed, 0x45, 0x2a, 0x5d, 0x5c, 0x23,
  0x22, 0x5d, 0x5c, 0x7e, 0xc9, 0xfe, 0x21, 0xd0, 0xfe, 0x0d, 0xc8, 0xfe,
  0x10, 0xd8, 0xfe, 0x18, 0x3f, 0xd8, 0x23, 0xfe, 0x16, 0x38, 0x01, 0x23,
  0x37, 0x22, 0x5d, 0x5c, 0xc9, 0xbf, 0x52, 0x4e, 0xc4, 0x49, 0x4e, 0x4b,
  0x45, 0x59, 0xa4, 0x50, 0xc9, 0x46, 0xce, 0x50, 0x4f, 0x49, 0x4e, 0xd4,
  0x53, 0x43, 0x52, 0x45, 0x45, 0x4e, 0xa4, 0x41, 0x54, 0x54, 0xd2, 0x41,
  0xd4, 0x54, 0x41, 0xc2, 0x56, 0x41, 0x4c, 0xa4, 0x43, 0x4f, 0x44, 0xc5,
  0x56, 0x41, 0xcc, 0x4c, 0x45, 0xce, 0x53, 0x49, 0xce, 0x43, 0x4f, 0xd3,
  0x54, 0x41, 0xce, 0x41, 0x53, 0xce, 0x41, 0x43, 0xd3, 0x41, 0x54, 0xce,
  0x4c, 0xce, 0x45, 0x58, 0xd0, 0x49, 0x4e, 0xd4, 0x53, 0x51, 0xd2, 0x53,
  0x47, 0xce, 0x41, 0x42, 0xd3, 0x50, 0x45, 0x45, 0xcb, 0x49, 0xce, 0x55,
  0x53, 0xd2, 0x53, 0x54, 0x52, 0xa4, 0x43, 0x48, 0x52, 0xa4, 0x4e, 0x4f,
  0xd4, 0x42, 0x49, 0xce, 0x4f, 0xd2, 0x41, 0x4e, 0xc4, 0x3c, 0xbd, 0x3e,
  0xbd, 0x3c, 0xbe, 0x4c, 0x49, 0x4e, 0xc5, 0x54, 0x48, 0x45, 0xce, 0x54,
  0xcf, 0x53, 0x54, 0x45, 0xd0, 0x44, 0x45, 0x46, 0x20, 0x46, 0xce, 0x43,
  0x41, 0xd4, 0x46, 0x4f, 0x52, 0x4d, 0x41, 0xd4, 0x4d, 0x4f, 0x56, 0xc5,
  0x45, 0x52, 0x41, 0x53, 0xc5, 0x4f, 0x50, 0x45, 0x4e, 0x20, 0xa3, 0x43,
  0x4c, 0x4f, 0x53, 0x45, 0x20, 0xa3, 0x4d, 0x45, 0x52, 0x47, 0xc5, 0x56,
  0x45, 0x52, 0x49, 0x46, 0xd9, 0x42, 0x45, 0x45, 0xd0, 0x43, 0x49, 0x52,
  0x43, 0x4c, 0xc5, 0x49, 0x4e, 0xcb, 0x50, 0x41, 0x50, 0x45, 0xd2, 0x46,
  0x4c, 0x41, 0x53, 0xc8, 0x42, 0x52, 0x49, 0x47, 0x48, 0xd4, 0x49, 0x4e,
  0x56, 0x45, 0x52, 0x53, 0xc5, 0x4f, 0x56, 0x45, 0xd2, 0x4f, 0x55, 0xd4,
  0x4c, 0x50, 0x52, 0x49, 0x4e, 0xd4, 0x4c, 0x4c, 0x49, 0x53, 0xd4, 0x53,
  0x54, 0x4f, 0xd0, 0x52, 0x45, 0x41, 0xc4, 0x44, 0x41, 0x54, 0xc1, 0x52,
  0x45, 0x53, 0x54, 0x4f, 0x52, 0xc5, 0x4e, 0x45, 0xd7, 0x42, 0x4f, 0x52,
  0x44, 0x45, 0xd2, 0x43, 0x4f, 0x4e, 0x54, 0x49, 0x4e, 0x55, 0xc5, 0x44,
  0x49, 0xcd, 0x52, 0x45, 0xcd, 0x46, 0x4f, 0xd2, 0x47, 0x4f, 0x20, 0x54,
  0xcf, 0x47, 0x4f, 0x20, 0x53, 0x55, 0xc2, 0x49, 0x4e, 0x50, 0x55, 0xd4,
  0x4c, 0x4f, 0x41, 0xc4, 0x4c, 0x49, 0x53, 0xd4, 0x4c, 0x45, 0xd4, 0x50,
  0x41, 0x55, 0x53, 0xc5, 0x4e, 0x45, 0x58, 0xd4, 0x50, 0x4f, 0x4b, 0xc5,
  0x50, 0x52, 0x49, 0x4e, 0xd4, 0x50, 0x4c, 0x4f, 0xd4, 0x52, 0x55, 0xce,
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
};
const unsigned int _48_original_rom_len = 16384;
