derekfountain/zx-spectrum-coprocessor/firmware/zx_memory_management.c

/*
 * ZX Coprocessor Firmware, a Raspberry Pi RP2350b based Spectrum device
 * Copyright (C) 2025 Derek Fountain
 * 
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
 * You should have received a copy of the GNU General Public License
 * along with this program; if not, write to the Free Software
 * Foundation, Inc., 51 Franklin Street, Fifth Floor, Boston, MA  02110-1301, USA.
 */

#include <string.h>

#include "hardware/gpio.h"
#include "pico/multicore.h"
#include "hardware/clocks.h"

#include "zx_memory_management.h"
#include "rom.h"
#include "zx_mirror.h"
#include "z80_test_image.h"

#include "gpios.h"

/*
 * Timings here are very tight. At 200MHz a single RP2350 instruction takes 5ns. 
 * Each cycle of the 3.5MHz Z80 is about 286ns, so there's time for 57 RP2350
 * instructions to execute in one Z80 cycle.
 * The Z80's M1 instruction fetch has MREQ low for one-and-a-half Z80 cycles. 
 * That's 85 RP2350 cycles to spot the MREQ, read the address bus, find the
 * data value and get it on the data bus.
 * I don't want to use a ridiculous overclock, 200MHz is fine, maybe a bit
 * faster if I really have to.
 * 
 * Testing shows 200MHz is fast enough for the time being. Comments in this code
 * are based on a 200MHz overclock.
 */

static uint16_t initial_jp_destination = 0;

void set_initial_jp( uint16_t dest )
{
  initial_jp_destination = dest;
}

void reset_initial_jp( void )
{
  initial_jp_destination = 0;
}

inline uint32_t using_rom_emulation( void )
{
#define EMULATE_ROM 0
  return EMULATE_ROM;
}

/*
 * As things stand:
 * ROM emulation can be on of off. It's only really used for testing.
 * Mirroring the Spectrum's RAM is always enabled.
 */
static EMULATION_MODE emulation_mode;

static void core1_rom_emulation( void )
{
  irq_set_mask_enabled( 0xFFFFFFFF, 0 );

  initial_jp_destination = 0;

  while( 1 )
  {
    const uint64_t mreq_mask = MREQ_MASK;
    const uint64_t rd_mask   = RD_MASK;
    const uint64_t wr_mask   = WR_MASK;

    uint64_t gpios;
    
    /* Spin, waiting for a memory request. (Approx 90ns to 100ns)  */
    while( ((gpios = gpio_get_all64()) & mreq_mask) );

    /* Pick up the address being accessed (approx 20ns) */
    uint64_t address = (gpios & GPIO_ABUS_BITMASK) >> GPIO_ABUS_A0;

    /* Is it a read that's happening? (Approx 35ns) */
    if( (gpios & rd_mask) == 0 )
    {
      if( emulation_mode == FULL_ROM_EMULATION )
      {
        /* Ignore reads from anywhere other than ROM, the Spectrum still reads its own RAM (Approx 15ns) */
        if( address <= 0x3FFF )
        {
          /* Pick up ROM byte from local image */
          uint8_t data = *(_48_original_rom+address);
#if 0
          if( using_z80_test_image() )
          {
            /* Inject JP to the z80 test code into bytes 0, 1 and 2 */
            if( initial_jp_destination != 0 )
            {
              if(      address == 0x0000 ) data = 0xc3;
              else if( address == 0x0001 ) data = (uint8_t)(initial_jp_destination & 0xFF);
              else if( address == 0x0002 ) data = (uint8_t)((initial_jp_destination >> 8) & 0xFF);
              }
            }
          }
#endif
          /* Set the data bus to outputs */
          gpio_set_dir_out_masked64( GPIO_DBUS_BITMASK );

          /* Write the value out to the Z80 */
          gpio_put_masked64( GPIO_DBUS_BITMASK, (data & 0xFF) << GPIO_DBUS_D0 );

          /*
           * As of this point the data is on the bus ready for the CPU to read it.
           * The read happens 428ns after MREQ goes low. This point is reached
           * after approx 300ns to 375ns. With a 270MHz overclock the data is
           * consistently ready about 200ns to 220ns after MREQ goes low.
           */
      
          /* Wait for the Z80's read to finish */
          while( (gpio_get_all64() & mreq_mask) == 0 );

          /* Z80 has picked up the byte, put data bus back to inputs */
          gpio_set_dir_in_masked64( GPIO_DBUS_BITMASK );
        }
        else
        {
          /*
           * It's a read from RAM, the Spectrum's RAM chips will field it.
           * Just wait for the read to finish we don't loop continuously
           * while this read is on the Z80 control bus
           */
          while( (gpio_get_all64() & mreq_mask) == 0 );
        }
      }
      else
      {
        /* It's a read, but we're not emulating the ZX ROM. Ignore it. */
      }
    }
    else if( (gpios & wr_mask) == 0 )
    {
      /*
       * Pick the value being written from the data bus and mirror it.
       * Writes to ROM will be written into the mirror, but they're not
       * accessed from there. The code above uses its own ROM image.
       * I did it this way for speed. There's not enough time here to
       * check if address is < 0x4000.
       */
      uint8_t data = (gpios & GPIO_DBUS_BITMASK) & 0xFF;
      put_zx_mirror_byte( address, data );

      /*
       * I don't attempt to wait for the MREQ to finish. The timing is too
       * tight, it's quicker just to let it go back to the top of the loop
       * and drop through here several times while the write completes.
       */
    }
    else
    {
      /*
       * MREQ is low, but it's not a read and it's not a write. It must be
       * a refresh. I don't attempt to wait for the MREQ to finish. The
       * timing is too tight, it's quicker just to let it go back to the
       * top of the loop and drop through here several times while the
       * refresh completes.
       */
    }
  } /* End infinite loop */
}


void start_rom_emulation( EMULATION_MODE mode )
{
  emulation_mode = mode;
  multicore_launch_core1( core1_rom_emulation );
}
