derekfountain/zx-spectrum-coprocessor/firmware/cmd.h

/*
 * ZX Coprocessor Firmware, a Raspberry Pi RP2350b based Spectrum device
 * Copyright (C) 2025 Derek Fountain
 * 
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
 * You should have received a copy of the GNU General Public License
 * along with this program; if not, write to the Free Software
 * Foundation, Inc., 51 Franklin Street, Fifth Floor, Boston, MA  02110-1301, USA.
 */

#ifndef __CMD_H
#define __CMD_H

#include <stdint.h>
#include <stdbool.h>
#include "zx_copro.h"
#include "dma_engine.h"

/*
 * These are the commands the coprocessor is able to fulfill.
 */
typedef enum
{
  ZXCOPRO_MEMSET_SMALL  = 128,
  ZXCOPRO_PXY2SADDR,

  ZXCOPRO_MEMSET_LARGE,          // FIXME Still not sure if commands which run on /int should be separate or flagged
}
ZXCOPRO_CMD;


/*
 * Error codes for the command structure.
 */
typedef enum
{
  CMD_ERR_BAD_STRUCT = DMA_STATUS_LAST,
  CMD_ERR_UNKNOWN_CMD,

  CMD_ERR_BAD_ARG,         // Arguments make no sense
  CMD_ERR_TOO_BIG,         // Number of bytes to DMA is too large
  CMD_ERR_BAD_INCR,        // An increment value is way out

  CMD_ERR_LAST
}
CMD_ERROR;

/* Flags the Z80 can pass into the coprocessor command */
typedef enum
{
  CMD_FLAG_IGNORE_INT = 0x01,     // Z80 program isn't worried about interrupts (probably DI'ed)
  CMD_FLAG_TOP_BORDER = 0x02,     // Z80 program is running this DMA in top border time
}
CMD_FLAGS;

/*
 * This structure defines a coprocessor request. It's created on the Spectrum
 * from where the coprocessor reads its contents (e.g. type) and writes back the
 * status and error codes as appropriate.
 * The bytes in the Spectrum memory which immediately follow this structure are
 * the arguments to the command, and are defined by 'type'.
 */
typedef struct _cmd_struct
{
  ZXCOPRO_CMD    type;      // Input to copro, the type of command the Z80 wants
                            // @TODO I could reuse this as the status output, save a byte?
  uint8_t        flags;     // Input to copro, see CMD_FLAGS enumeration

  ZXCOPRO_STATUS status;    // Output from copro, the final status of the command
  CMD_ERROR      error;     // Output from copro, if status is ZXCOPRO_ERROR, this
                            // can contain a further error code
}
CMD_STRUCT;

void dma_status_to_zx( ZXCOPRO_STATUS status, ZX_ADDR status_zx_addr, ZX_ADDR error_zx_addr );
void dma_error_to_zx( ZXCOPRO_STATUS status, ZX_ADDR status_zx_addr, ZX_ADDR error_zx_addr );

#endif
