derekfountain/zx-spectrum-coprocessor/(commit log)

2025-03-17 pick up hardware design from my ZX Spectrum DMA project, stamp footprints are not a sub module
    [RP2xxx_Stamp.SchLib, zx-spectrum-coprocessor.kicad_pcb, zx-spectrum-coprocessor.kicad_sch]
2025-03-17 pick up DMA code, strip out most of what it does
2025-03-19 DMA a test program over to the ZX now works
2025-03-19 z80 test code reset idea working, not sure it's the right thing to do as yet
    [zx_copro.c]
2025-03-21 DMA is working, but ROM emulation has a weird glitch I haven't yet been able to track down
    [rom_emulation.c, rom_emulation.h, z80_test_image.c, z80_test_image.h, zx_copro.c, zx_mirror.c]
2025-03-21 rom emulation and z80 test image seem ok on my issue 2, other than a garbled startup screen
    [rom_emulation.c, zx_copro.c]
2025-03-25 more rom emulation optimisation, it's very tight but current ok at 220MHz
    [rom_emulation.c, zx_mirror.c]
2025-03-26 DMA of PIO result back into core0 is working, still bit of a mess
2025-03-27 interrupt unsafe code now working and tidy
2025-04-11 maybe temp commit; this is a partial rework, remobing the rom emulation. but it uncovered what may be an issue with the DMA code which needs fixing. if i go back to a stable commit i'll likely lose t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
    [dma_engine.c, rom_emulation.c, rom_emulation.h, z80_test_image.c, zx_copro.c]
2025-04-11 rework the DMA loop to match Z80 clock sync, trying to stabilise and fix corruptions in DMA
    [dma_engine.c]
2025-04-12 DMA works with Z80 timings, i can do better. the rom emulation first-3-bytes idea doesn't work. it's in here, but needs to come out again.
    [dma_engine.c, rom_emulation.c, zx_copro.c]
2025-04-12 re-establish the rom emulation. it doesn't work, and is switched off. still not sure how to fix it because i don't understand the problem. plan is to get the DMA working in all circumstances, get a s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
    [rom_emulation.c, rom_emulation.h, zx_copro.c]
2025-04-20 trying to trace weirdness with the interrupt protection PIO, this is stable with new SDK
2025-04-21 fix PIO weirdness bus, automatic variable in the DMA transfer
    [dma_engine.c, zx_copro.c]
2025-04-23 more refactoring, response now DMAed to zx, test case now spins on response
2025-04-24 flesh out the memset test a bit, add better error handling, needs rethinking
    [cmd.c, cmd.h, cmd_immediate.c, cmd_immediate.h, dma_engine.c, dma_engine.h, z80_image.h]
2025-04-25 improve memset testcase, confirm contended DMA doesn't work, not sure why
    [z80_image.h]
2025-04-29 change the DMA response to a status
2025-04-29 create DMA modes, this commit has the DMA_MODE_UNCONTENDED reworked to be as fast as the logic chips can run. Maybe.
    [cmd.h, dma_engine.c, z80_image.h]
2025-05-06 more fine tuning of the DMA procedures, add a very basic trace table facility
