derekfountain/zx-spectrum-coprocessor/(notices)

Notices in the files:
firmware/dma_engine.c:
modify it under the terms of the GNU General Public License
